WillA97/STM32_Play_Board/README.md

# STM32_Play_Board
 schematic of the microcontroller pcb files
