WillA97/STM32_Play_Board/STM32_Play_Board.kicad_pcb

## KiCad design STM32_Play_Board.kicad_pcb (2024-08-05)

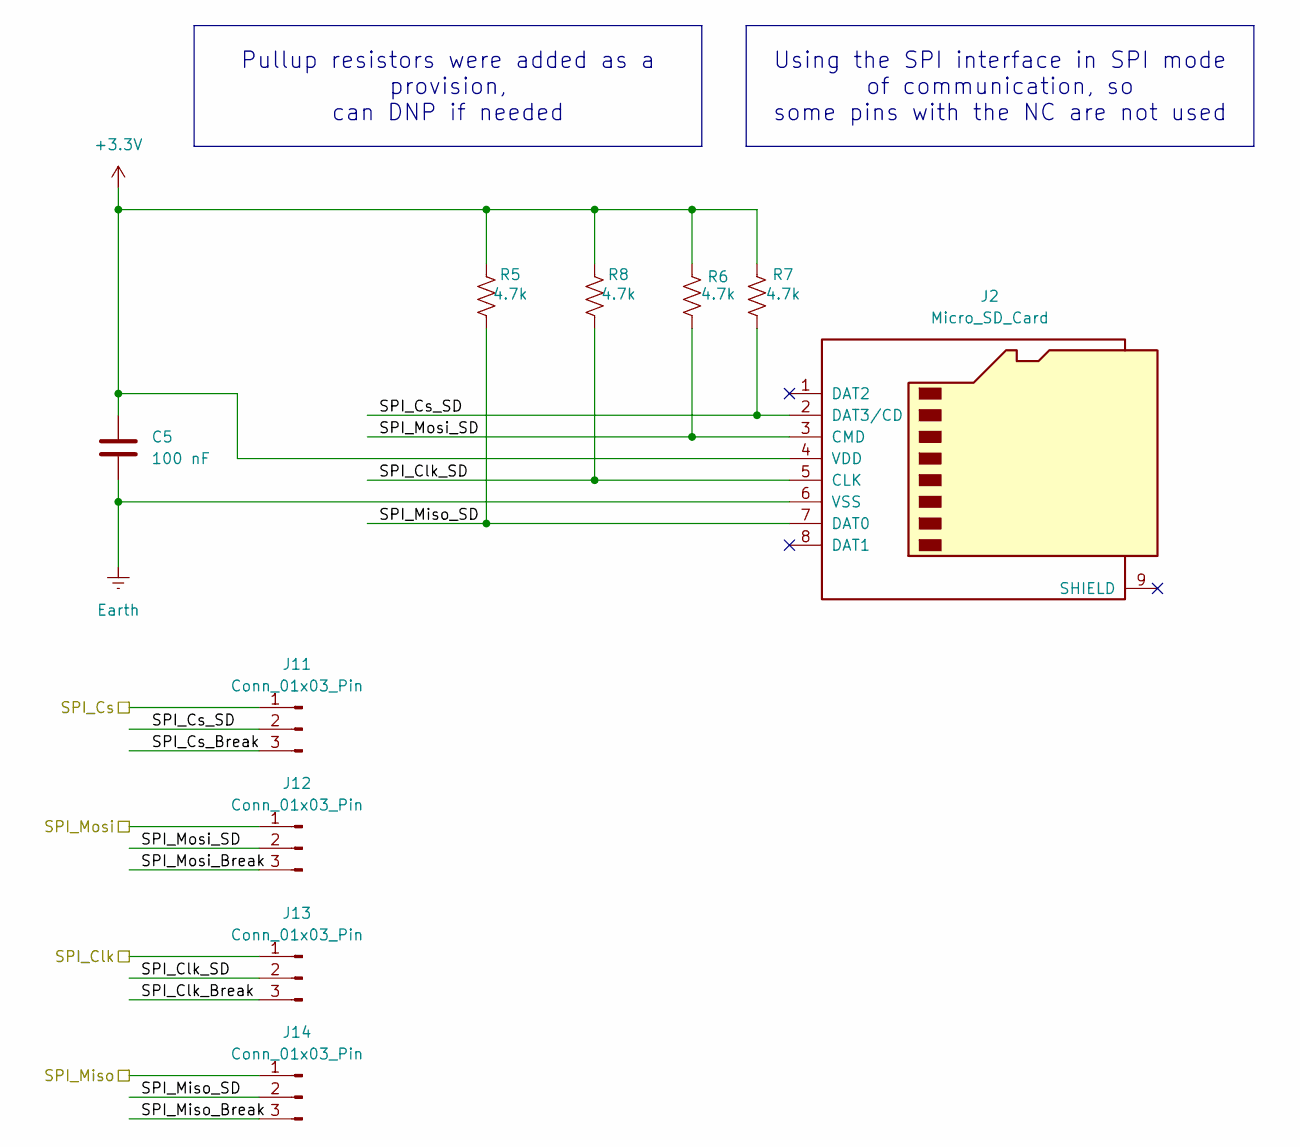
[picture p1: schematic SD_CARD.kicad_sch]

Parts:
C5: 100 nF; C_0805_2012Metric
J2: Micro_SD_Card; microSD_HC_Molex_104031-0811
J11, J12, J13, J14: Conn_01x03_Pin; PinHeader_1x03_P2.54mm_Vertical
R5, R6, R7, R8: 4.7k; R_0805_2012Metric

Connections:
+3.3V: C5.1, J2.4 (VDD), R5.1, R6.1, R7.1, R8.1; also elsewhere on the board
/Micrcontroller STM32C0/SPI_Clk: J13.1; also elsewhere on the board
/Micrcontroller STM32C0/SPI_Cs: J11.1; also elsewhere on the board
/Micrcontroller STM32C0/SPI_Miso: J14.1; also elsewhere on the board
/Micrcontroller STM32C0/SPI_Mosi: J12.1; also elsewhere on the board
/SD_CARD/SPI_Clk_Break: J13.3
/SD_CARD/SPI_Clk_SD: J2.5 (CLK), J13.2, R8.2
/SD_CARD/SPI_Cs_Break: J11.3
/SD_CARD/SPI_Cs_SD: J2.2 (DAT3/CD), J11.2, R7.2
/SD_CARD/SPI_Miso_Break: J14.3
/SD_CARD/SPI_Miso_SD: J2.7 (DAT0), J14.2, R5.2
/SD_CARD/SPI_Mosi_Break: J12.3
/SD_CARD/SPI_Mosi_SD: J2.3 (CMD), J12.2, R6.2
Earth: C5.2, J2.6 (VSS); also elsewhere on the board

Notes on the sheet:
Using the SPI interface in SPI mode of communication, so some pins with the NC are not used
Pullup resistors were added as a provision, can DNP if needed

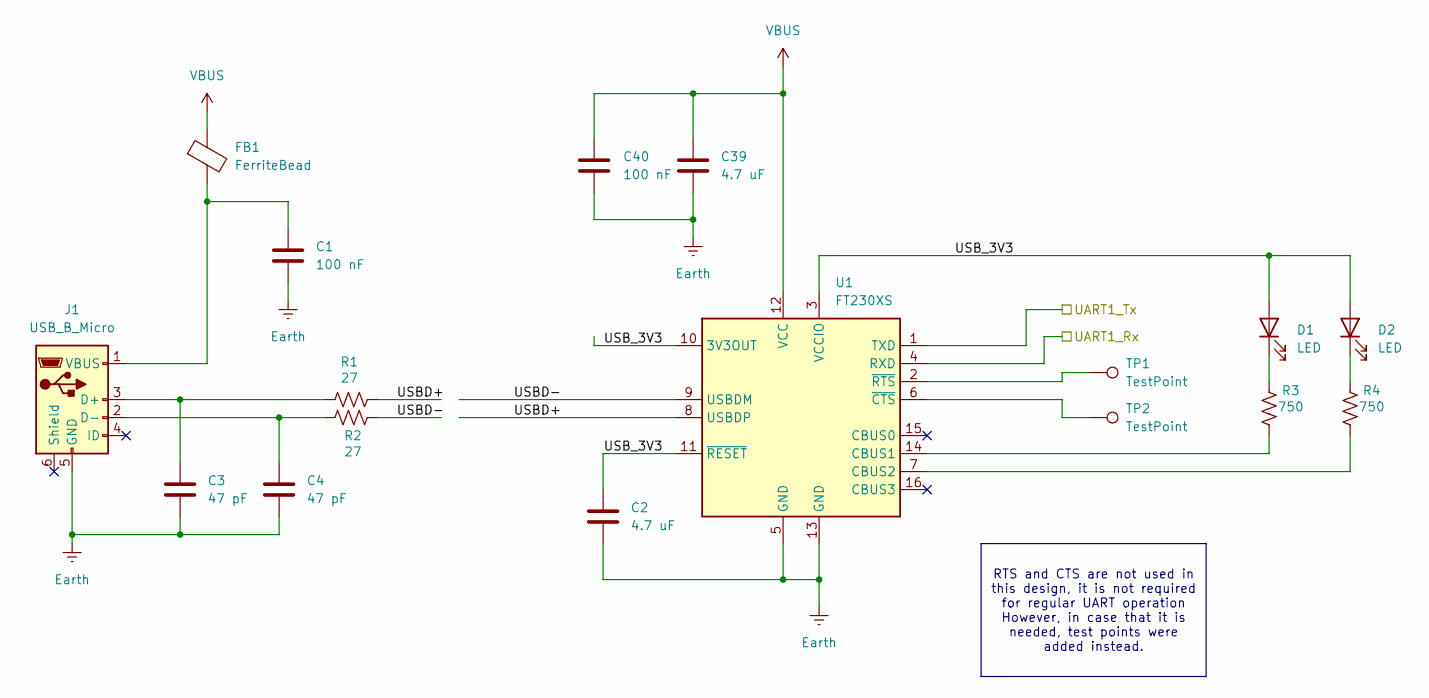
[picture p2: schematic USB_to_UART.kicad_sch]

Parts:
C1, C40: 100 nF; C_0805_2012Metric
C2, C39: 4.7 uF; C_0805_2012Metric
C3, C4: 47 pF; C_0805_2012Metric
D1, D2: LED; LED_0805_2012Metric
FB1: FerriteBead; L_0805_2012Metric
J1: USB_B_Micro; USB_Micro-B_Wuerth_629105150521
R1, R2: 27; R_0805_2012Metric
R3, R4: 750; R_0805_2012Metric
TP1, TP2: TestPoint; TestPoint_Pad_2.0x2.0mm
U1: FT230XS; SSOP-16_3.9x4.9mm_P0.635mm

Connections:
/Micrcontroller STM32C0/UART1_Rx: U1.4 (RXD); also elsewhere on the board
/Micrcontroller STM32C0/UART1_Tx: U1.1 (TXD); also elsewhere on the board
/USB to UART/USBD+: R1.2, U1.8 (USBDP)
/USB to UART/USBD-: R2.2, U1.9 (USBDM)
/USB to UART/USB_3V3: C2.1, D1.2 (A), D2.2 (A), U1.3 (VCCIO), U1.10 (3V3OUT), U1.11 (~RESET)
Earth: C1.2, C2.2, C3.2, C4.2, C39.2, C40.2, J1.5 (GND), U1.5 (GND), U1.13 (GND); also elsewhere on the board
unnamed: D1.1 (K), R3.1
unnamed: D2.1 (K), R4.1
unnamed: C3.1, J1.3 (D+), R1.1
unnamed: C4.1, J1.2 (D-), R2.1
unnamed: C1.1, FB1.2, J1.1 (VBUS)
unnamed: R3.2, U1.14 (CBUS1)
unnamed: R4.2, U1.7 (CBUS2)
unnamed: TP2.1, U1.6 (~CTS)
unnamed: TP1.1, U1.2 (~RTS)
VBUS: C39.1, C40.1, FB1.1, U1.12 (VCC); also elsewhere on the board

Notes on the sheet:
RTS and CTS are not used in this design, it is not required for regular UART operation However, in case that it is needed, test points were added instead.

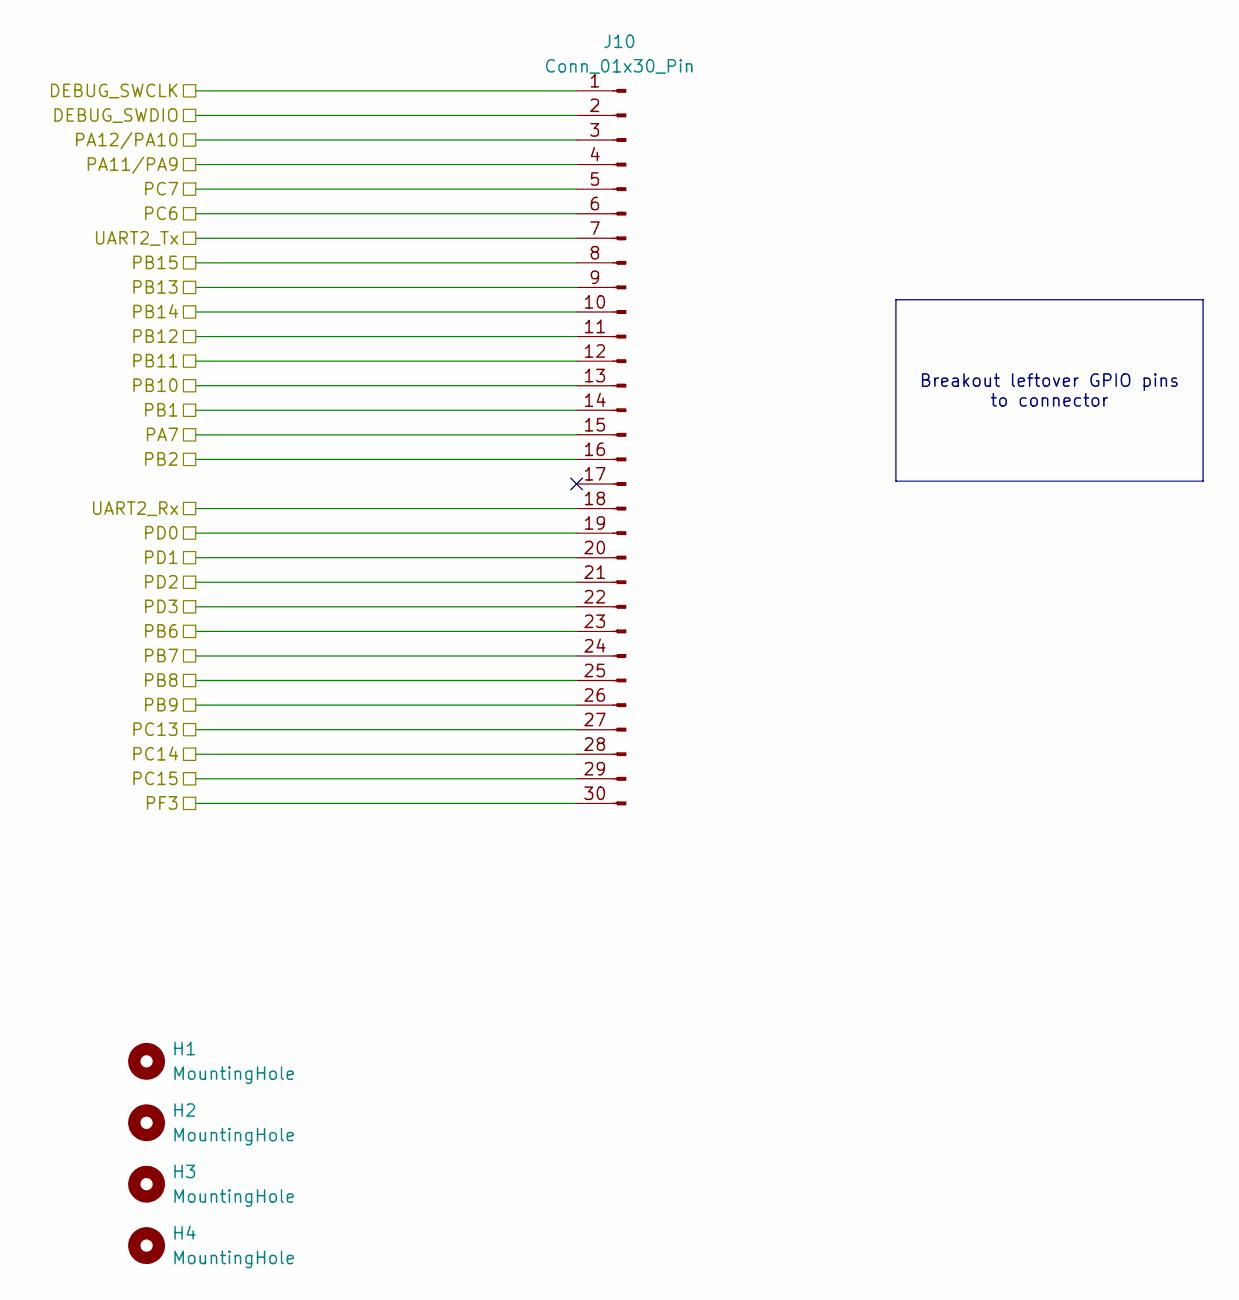
[picture p3: schematic Connectors.kicad_sch]

Parts:
H1, H2, H3, H4: MountingHole; MountingHole_3.2mm_M3
J10: Conn_01x30_Pin; PinHeader_1x30_P2.54mm_Vertical

Connections:
/Connectors/DEBUG_SWCLK: J10.1; also elsewhere on the board
/Connectors/DEBUG_SWDIO: J10.2; also elsewhere on the board
/Connectors/PA7: J10.15; also elsewhere on the board
/Connectors/PA11/PA9: J10.4; also elsewhere on the board
/Connectors/PA12/PA10: J10.3; also elsewhere on the board
/Connectors/PB1: J10.14; also elsewhere on the board
/Connectors/PB2: J10.16; also elsewhere on the board
/Connectors/PB6: J10.23; also elsewhere on the board
/Connectors/PB7: J10.24; also elsewhere on the board
/Connectors/PB8: J10.25; also elsewhere on the board
/Connectors/PB9: J10.26; also elsewhere on the board
/Connectors/PB10: J10.13; also elsewhere on the board
/Connectors/PB11: J10.12; also elsewhere on the board
/Connectors/PB12: J10.11; also elsewhere on the board
/Connectors/PB13: J10.9; also elsewhere on the board
/Connectors/PB14: J10.10; also elsewhere on the board
/Connectors/PB15: J10.8; also elsewhere on the board
/Connectors/PC6: J10.6; also elsewhere on the board
/Connectors/PC7: J10.5; also elsewhere on the board
/Connectors/PC13: J10.27; also elsewhere on the board
/Connectors/PC14: J10.28; also elsewhere on the board
/Connectors/PC15: J10.29; also elsewhere on the board
/Connectors/PD0: J10.19; also elsewhere on the board
/Connectors/PD1: J10.20; also elsewhere on the board
/Connectors/PD2: J10.21; also elsewhere on the board
/Connectors/PD3: J10.22; also elsewhere on the board
/Connectors/PF3: J10.30; also elsewhere on the board
/Micrcontroller STM32C0/UART2_Rx: J10.18; also elsewhere on the board
/Micrcontroller STM32C0/UART2_Tx: J10.7; also elsewhere on the board

Notes on the sheet:
Breakout leftover GPIO pins to connector

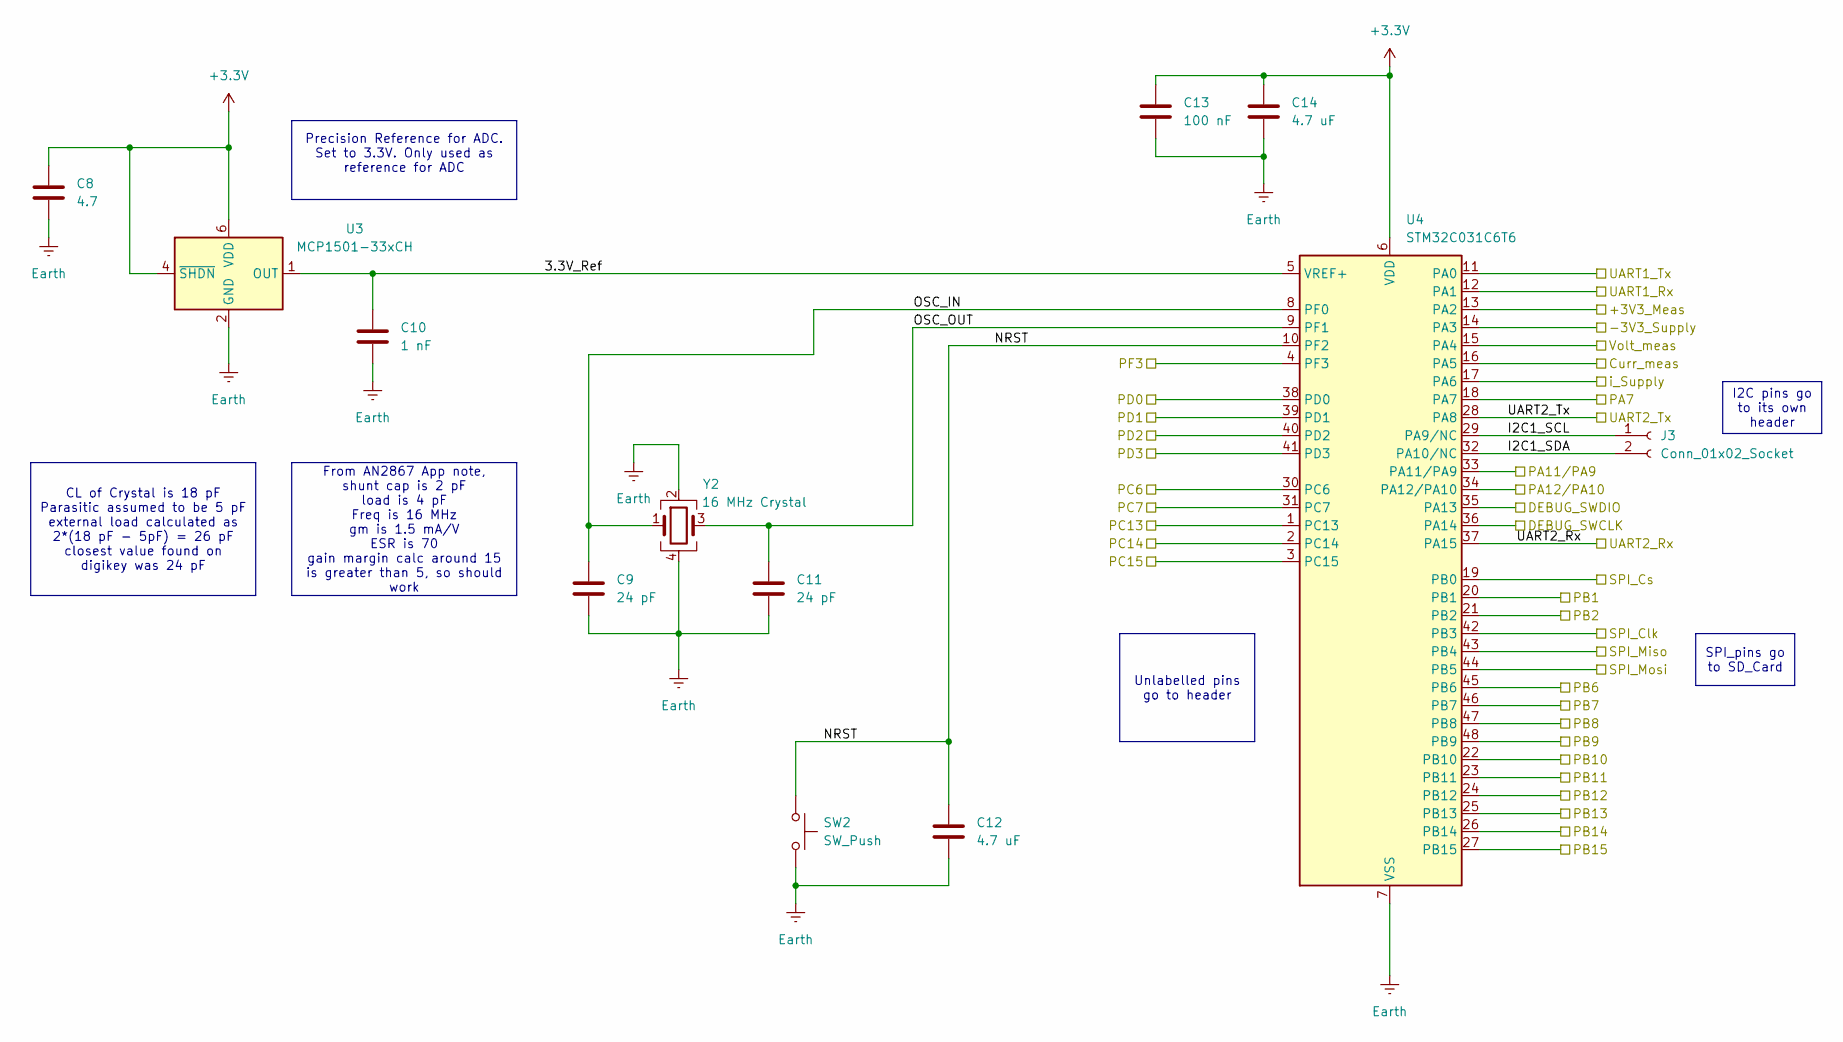
[picture p4: schematic Microntroller.kicad_sch]

Parts:
C8: 4.7; C_0805_2012Metric
C9, C11: 24 pF; C_0805_2012Metric
C10: 1 nF; C_0805_2012Metric
C12, C14: 4.7 uF; C_0805_2012Metric
C13: 100 nF; C_0805_2012Metric
J3: Conn_01x02_Socket; Molex_KK-254_AE-6410-02A_1x02_P2.54mm_Vertical
SW2: SW_Push; SW_PUSH_6mm
U3: MCP1501-33xCH; SOT-23-6
U4: STM32C031C6T6; LQFP-48_7x7mm_P0.5mm
Y2: 16 MHz Crystal; Oscillator_SMD_Abracon_ASE-4Pin_3.2x2.5mm_HandSoldering

Connections:
+3.3V: C8.1, C13.1, C14.1, U3.4 (~SHDN), U3.6 (VDD), U4.6 (VDD); also elsewhere on the board
/Connectors/DEBUG_SWCLK: U4.36 (PA14); also elsewhere on the board
/Connectors/DEBUG_SWDIO: U4.35 (PA13); also elsewhere on the board
/Connectors/PA7: U4.18 (PA7); also elsewhere on the board
/Connectors/PA11/PA9: U4.33 (PA11/PA9); also elsewhere on the board
/Connectors/PA12/PA10: U4.34 (PA12/PA10); also elsewhere on the board
/Connectors/PB1: U4.20 (PB1); also elsewhere on the board
/Connectors/PB2: U4.21 (PB2); also elsewhere on the board
/Connectors/PB6: U4.45 (PB6); also elsewhere on the board
/Connectors/PB7: U4.46 (PB7); also elsewhere on the board
/Connectors/PB8: U4.47 (PB8); also elsewhere on the board
/Connectors/PB9: U4.48 (PB9); also elsewhere on the board
/Connectors/PB10: U4.22 (PB10); also elsewhere on the board
/Connectors/PB11: U4.23 (PB11); also elsewhere on the board
/Connectors/PB12: U4.24 (PB12); also elsewhere on the board
/Connectors/PB13: U4.26 (PB14); also elsewhere on the board
/Connectors/PB14: U4.25 (PB13); also elsewhere on the board
/Connectors/PB15: U4.27 (PB15); also elsewhere on the board
/Connectors/PC6: U4.30 (PC6); also elsewhere on the board
/Connectors/PC7: U4.31 (PC7); also elsewhere on the board
/Connectors/PC13: U4.1 (PC13); also elsewhere on the board
/Connectors/PC14: U4.2 (PC14); also elsewhere on the board
/Connectors/PC15: U4.3 (PC15); also elsewhere on the board
/Connectors/PD0: U4.38 (PD0); also elsewhere on the board
/Connectors/PD1: U4.39 (PD1); also elsewhere on the board
/Connectors/PD2: U4.40 (PD2); also elsewhere on the board
/Connectors/PD3: U4.41 (PD3); also elsewhere on the board
/Connectors/PF3: U4.4 (PF3); also elsewhere on the board
/Micrcontroller STM32C0/3.3V_Ref: C10.1, U3.1 (OUT), U4.5 (VREF+)
/Micrcontroller STM32C0/+3V3_Meas: U4.13 (PA2); also elsewhere on the board
/Micrcontroller STM32C0/-3V3_Supply: U4.14 (PA3); also elsewhere on the board
/Micrcontroller STM32C0/Curr_meas: U4.16 (PA5); also elsewhere on the board
/Micrcontroller STM32C0/I2C1_SCL: J3.1, U4.29 (PA9/NC)
/Micrcontroller STM32C0/I2C1_SDA: J3.2, U4.32 (PA10/NC)
/Micrcontroller STM32C0/NRST: C12.1, SW2.1, U4.10 (PF2)
/Micrcontroller STM32C0/OSC_IN: C9.1, U4.8 (PF0), Y2.1
/Micrcontroller STM32C0/OSC_OUT: C11.1, U4.9 (PF1), Y2.3
/Micrcontroller STM32C0/SPI_Clk: U4.42 (PB3); also elsewhere on the board
/Micrcontroller STM32C0/SPI_Cs: U4.19 (PB0); also elsewhere on the board
/Micrcontroller STM32C0/SPI_Miso: U4.43 (PB4); also elsewhere on the board
/Micrcontroller STM32C0/SPI_Mosi: U4.44 (PB5); also elsewhere on the board
/Micrcontroller STM32C0/UART1_Rx: U4.12 (PA1); also elsewhere on the board
/Micrcontroller STM32C0/UART1_Tx: U4.11 (PA0); also elsewhere on the board
/Micrcontroller STM32C0/UART2_Rx: U4.37 (PA15); also elsewhere on the board
/Micrcontroller STM32C0/UART2_Tx: U4.28 (PA8); also elsewhere on the board
/Micrcontroller STM32C0/Volt_meas: U4.15 (PA4); also elsewhere on the board
/Micrcontroller STM32C0/i_Supply: U4.17 (PA6); also elsewhere on the board
Earth: C8.2, C9.2, C10.2, C11.2, C12.2, C13.2, C14.2, SW2.2, U3.2 (GND), U3.3 (GND), U3.5 (GND), U4.7 (VSS), Y2.2, Y2.4; also elsewhere on the board

Notes on the sheet:
Precision Reference for ADC. Set to 3.3V. Only used as reference for ADC
Unlabelled pins go to header
I2C pins go to its own header
CL of Crystal is 18 pF Parasitic assumed to be 5 pF external load calculated as 2*(18 pF - 5pF) = 26 pF closest value found on digikey was 24 pF
From AN2867 App note, shunt cap is 2 pF load is 4 pF Freq is 16 MHz gm is 1.5 mA/V ESR is 70 gain margin calc around 15 is greater than 5, so should work
SPI_pins go to SD_Card

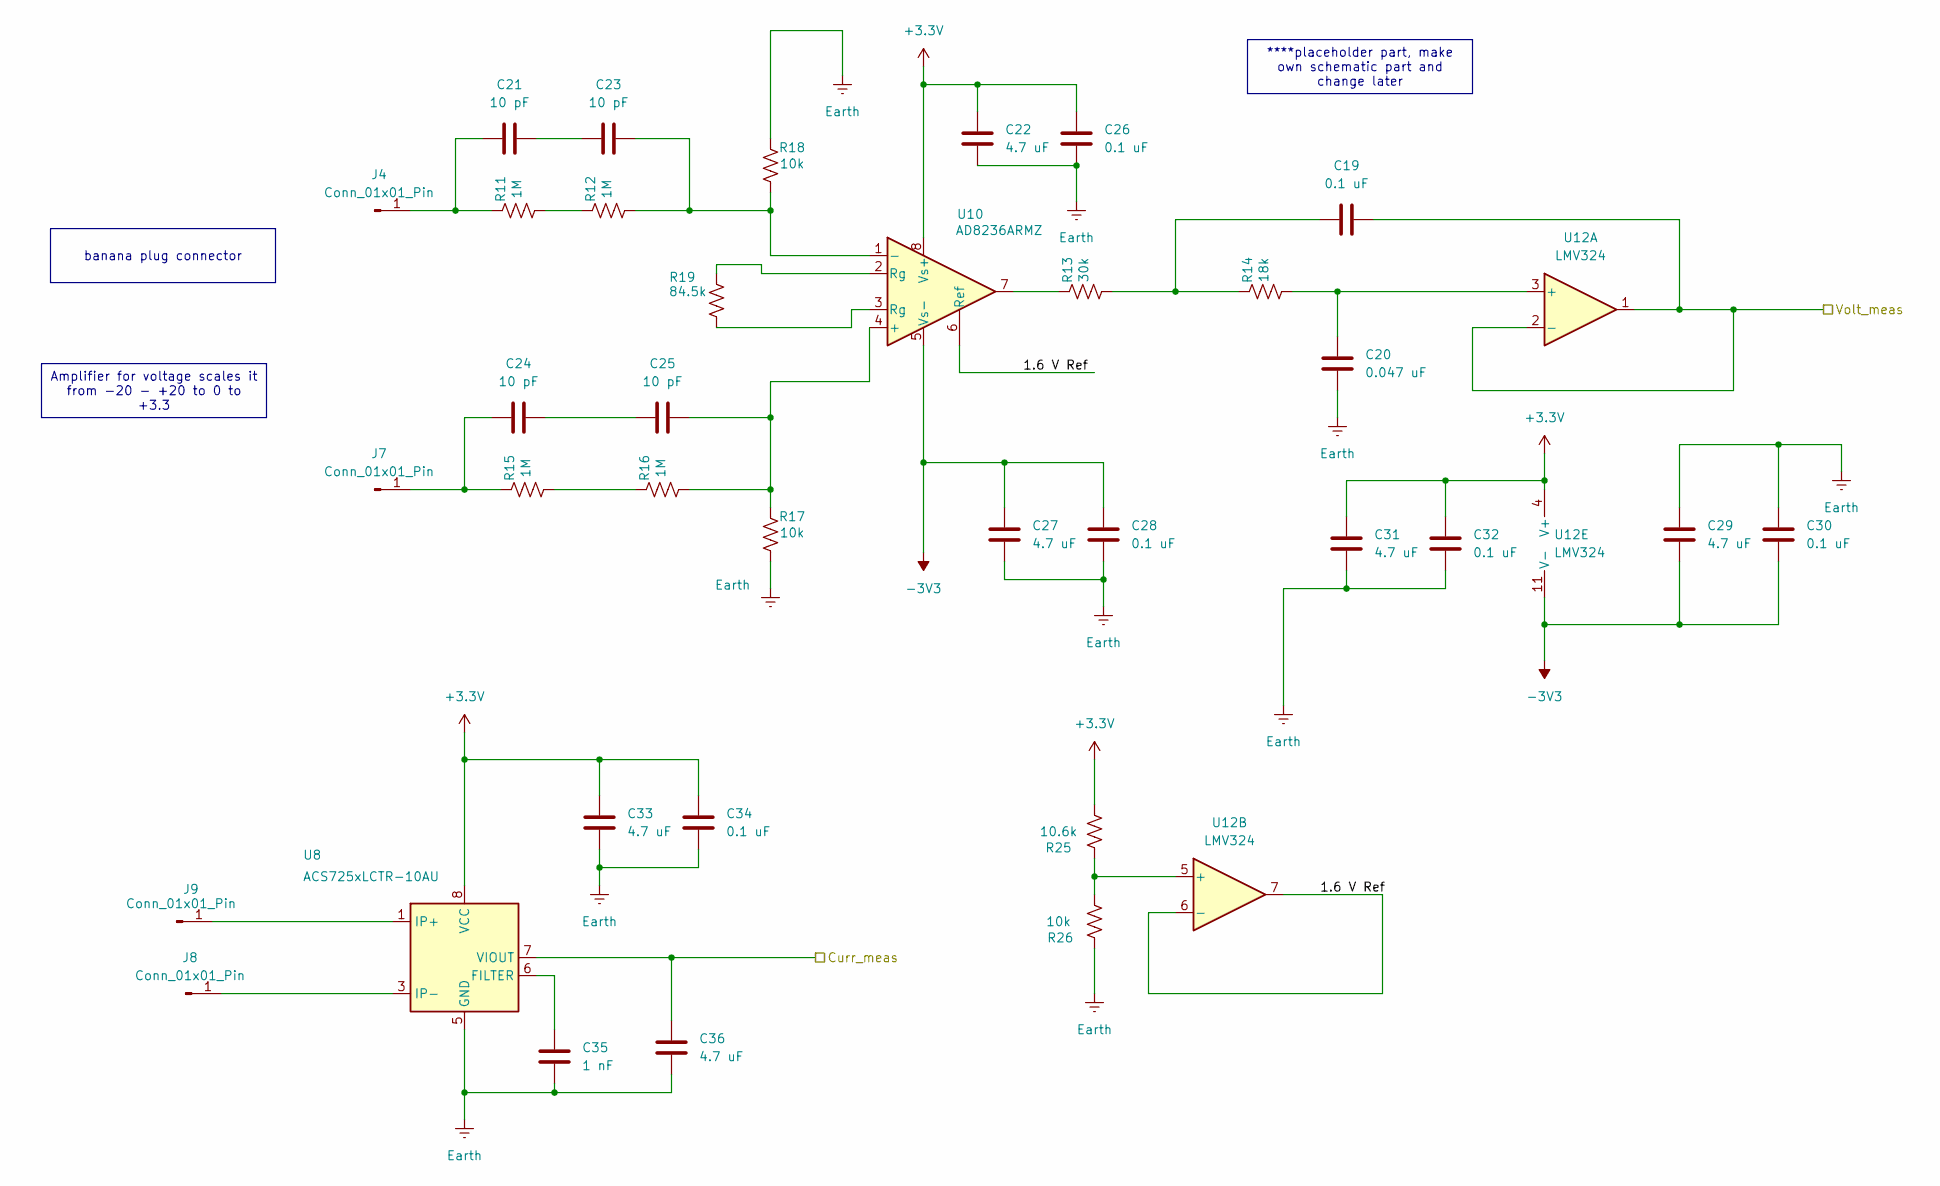
[picture p5: schematic Voltage_and_Current_Measurement.kicad_sch]

Parts:
C19, C26, C28, C30, C32, C34: 0.1 uF; C_0805_2012Metric
C20: 0.047 uF; C_0805_2012Metric
C21, C23, C24, C25: 10 pF; C_0805_2012Metric
C22, C27, C29, C31, C33, C36: 4.7 uF; C_0805_2012Metric
C35: 1 nF; C_0805_2012Metric
J4, J7, J8, J9: Conn_01x01_Pin; Banana_Jack_1Pin
R11, R12, R15, R16: 1M; R_0805_2012Metric
R13: 30k; R_0805_2012Metric
R14: 18k; R_0805_2012Metric
R17, R18, R26: 10k; R_0805_2012Metric
R19: 84.5k; R_0805_2012Metric
R25: 10.6k; R_0805_2012Metric
U8: ACS725xLCTR-10AU; SOIC-8_3.9x4.9mm_P1.27mm
U10: AD8236ARMZ; MSOP-8_3x3mm_P0.65mm
U12: LMV324; SOIC-14_3.9x8.7mm_P1.27mm_STM32_Play

Connections:
+3.3V: C22.2, C26.2, C31.2, C32.2, C33.2, C34.2, R25.2, U8.8 (VCC), U10.8 (Vs+), U12.4 (V+); also elsewhere on the board
-3V3: C27.2, C28.2, C29.1, C30.1, U10.5 (Vs-), U12.11 (V-); also elsewhere on the board
/Micrcontroller STM32C0/Curr_meas: C36.2, U8.7 (VIOUT); also elsewhere on the board
/Micrcontroller STM32C0/Volt_meas: C19.2, U12.1, U12.2 (-); also elsewhere on the board
/Voltage and Current Measurement/1.6 V Ref: U10.6 (Ref), U12.6 (-), U12.7
Earth: C20.1, C22.1, C26.1, C27.1, C28.1, C29.2, C30.2, C31.1, C32.1, C33.1, C34.1, C35.1, C36.1, R17.2, R18.1, R26.1, U8.5 (GND); also elsewhere on the board
unnamed: C19.1, R13.2, R14.1
unnamed: C21.2, C23.1
unnamed: C24.2, C25.1
unnamed: C21.1, J4.1, R11.1
unnamed: C24.1, J7.1, R15.1
unnamed: J8.1, U8.3 (IP-), U8.4 (IP-)
unnamed: J9.1, U8.1 (IP+), U8.2 (IP+)
unnamed: R11.2, R12.1
unnamed: R13.1, U10.7
unnamed: R15.2, R16.1
unnamed: R19.1, U10.2 (Rg)
unnamed: R19.2, U10.3 (Rg)
unnamed: C35.2, U8.6 (FILTER)
unnamed: C25.2, R16.2, R17.1, U10.4 (+)
unnamed: C23.2, R12.2, R18.2, U10.1 (-)
unnamed: C20.2, R14.2, U12.3 (+)
unnamed: R25.1, R26.2, U12.5 (+)

Notes on the sheet:
Amplifier for voltage scales it from -20 - +20 to 0 to +3.3
****placeholder part, make own schematic part and change later
banana plug connector

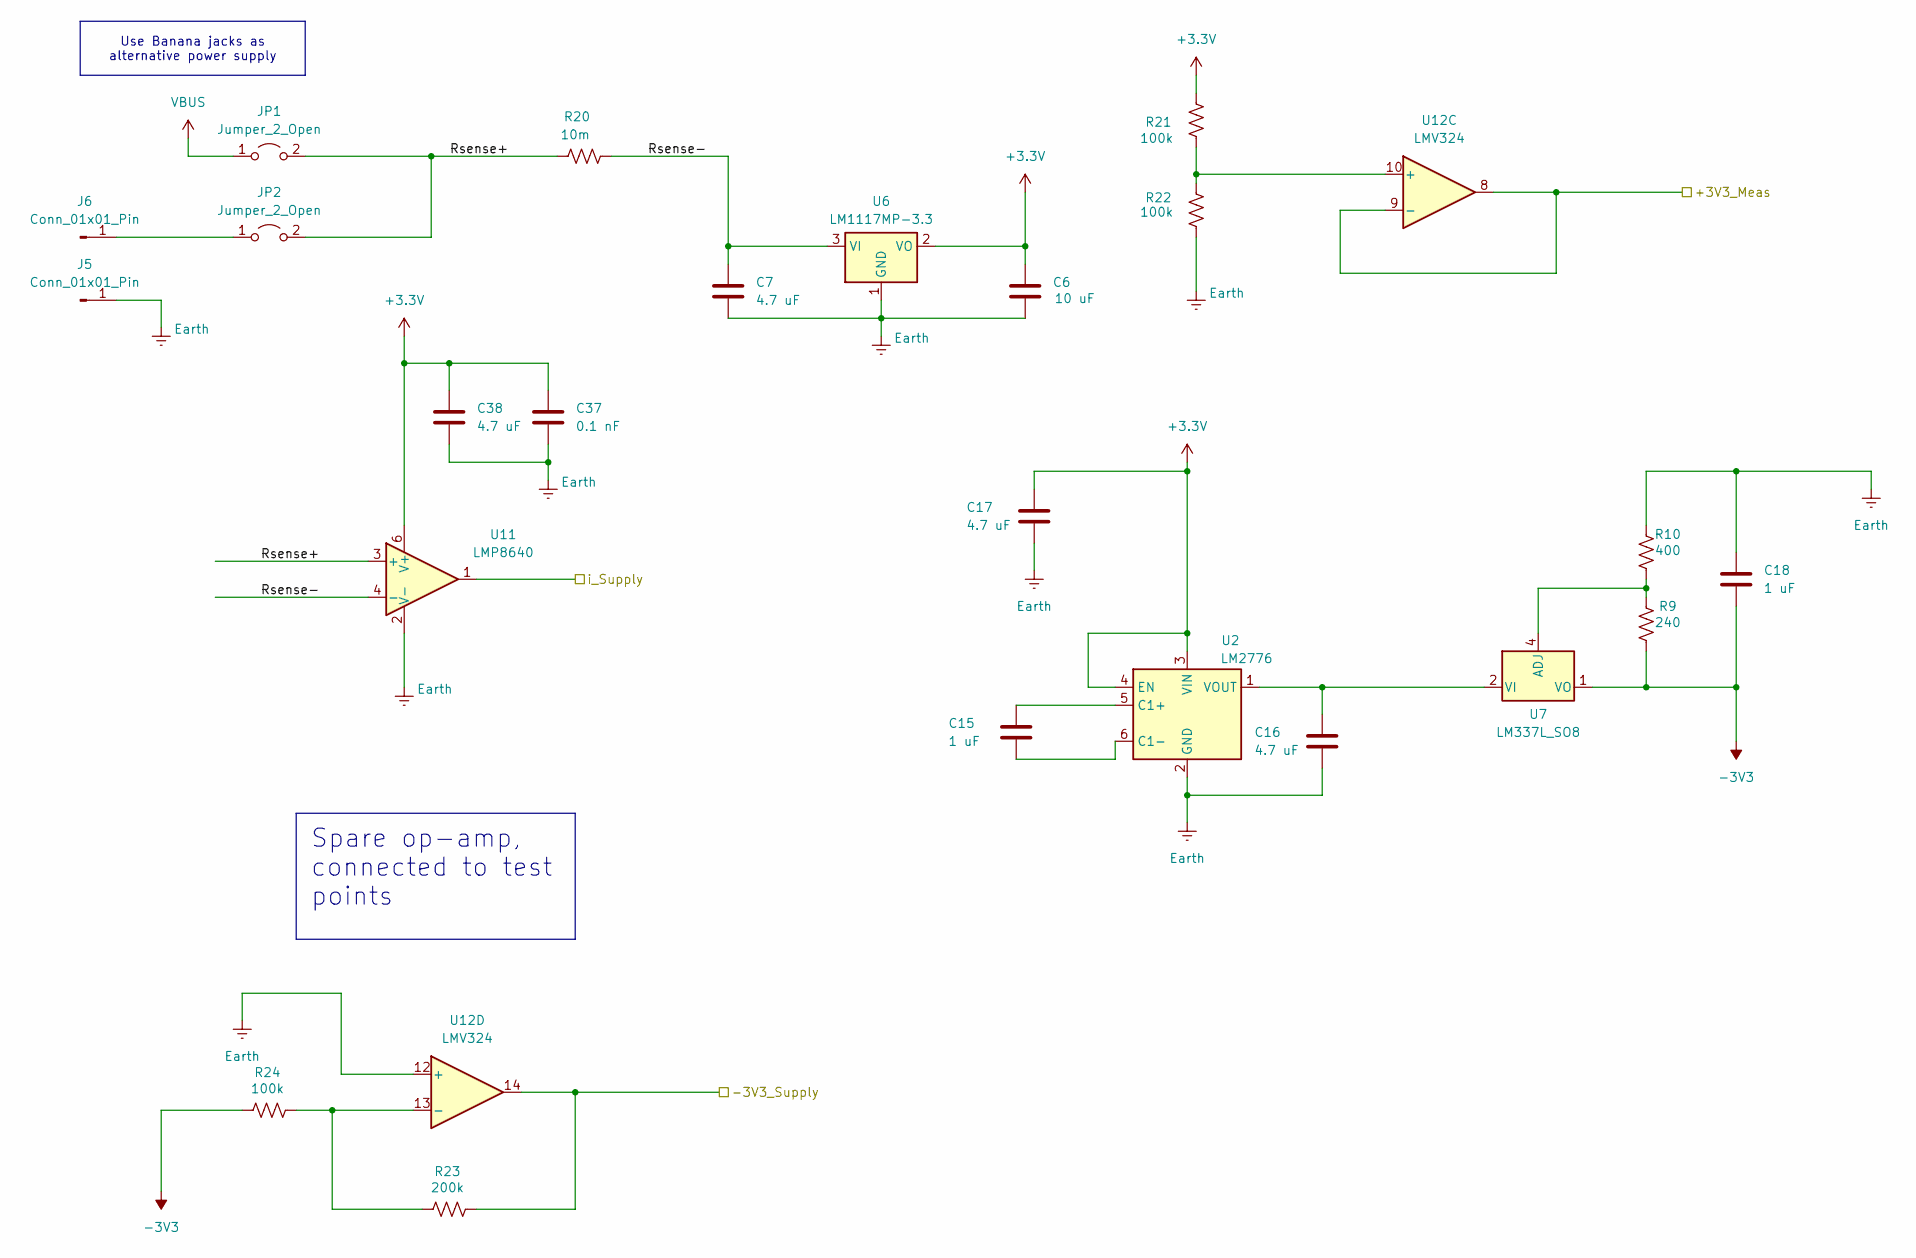
[picture p6: schematic Power.kicad_sch]

Parts:
C6: 10 uF; C_0805_2012Metric
C7, C16, C17, C38: 4.7 uF; C_0805_2012Metric
C15, C18: 1 uF; C_0805_2012Metric
C37: 0.1 nF; C_0805_2012Metric
J5: Conn_01x01_Pin; TestPoint_THTPad_D1.5mm_Drill0.7mm
J6: Conn_01x01_Pin; TestPoint_THTPad_1.5x1.5mm_Drill0.7mm
JP1, JP2: Jumper_2_Open; PinHeader_1x02_P2.54mm_Vertical
R9: 240; R_0805_2012Metric
R10: 400; R_0805_2012Metric
R20: 10m; R_0805_2012Metric
R21, R22, R24: 100k; R_0805_2012Metric
R23: 200k; R_0805_2012Metric
U2: LM2776; SOT-23-6
U6: LM1117MP-3.3; SOT-223-3_TabPin2
U7: LM337L_SO8; SOIC-8_3.9x4.9mm_P1.27mm
U11: LMP8640; SOT-23-6
U12: LMV324; SOIC-14_3.9x8.7mm_P1.27mm_STM32_Play

Connections:
+3.3V: C6.1, C17.1, C37.1, C38.1, R21.2, U2.3 (VIN), U2.4 (EN), U6.2 (VO), U11.6 (V+); also elsewhere on the board
-3V3: C18.2, R9.2, R24.1, U7.1 (VO); also elsewhere on the board
/Micrcontroller STM32C0/+3V3_Meas: U12.8, U12.9 (-); also elsewhere on the board
/Micrcontroller STM32C0/-3V3_Supply: R23.2, U12.14; also elsewhere on the board
/Micrcontroller STM32C0/i_Supply: U11.1; also elsewhere on the board
/Power/Rsense+: JP1.2 (B), JP2.2 (B), R20.1, U11.3 (+)
/Power/Rsense-: C7.1, R20.2, U6.3 (VI), U11.4 (-)
Earth: C6.2, C7.2, C16.2, C17.2, C18.1, C37.2, C38.2, J5.1, R10.1, R22.1, U2.2 (GND), U6.1 (GND), U11.2 (V-), U12.12 (+); also elsewhere on the board
unnamed: J6.1, JP2.1 (A)
unnamed: C15.1, U2.5 (C1+)
unnamed: C15.2, U2.6 (C1-)
unnamed: C16.1, U2.1 (VOUT), U7.2 (VI), U7.3 (VI), U7.6 (VI), U7.7 (VI)
unnamed: R9.1, R10.2, U7.4 (ADJ)
unnamed: R21.1, R22.2, U12.10 (+)
unnamed: R23.1, R24.2, U12.13 (-)
VBUS: JP1.1 (A); also elsewhere on the board

Notes on the sheet:
Spare op-amp, connected to test points
Use Banana jacks as alternative power supply

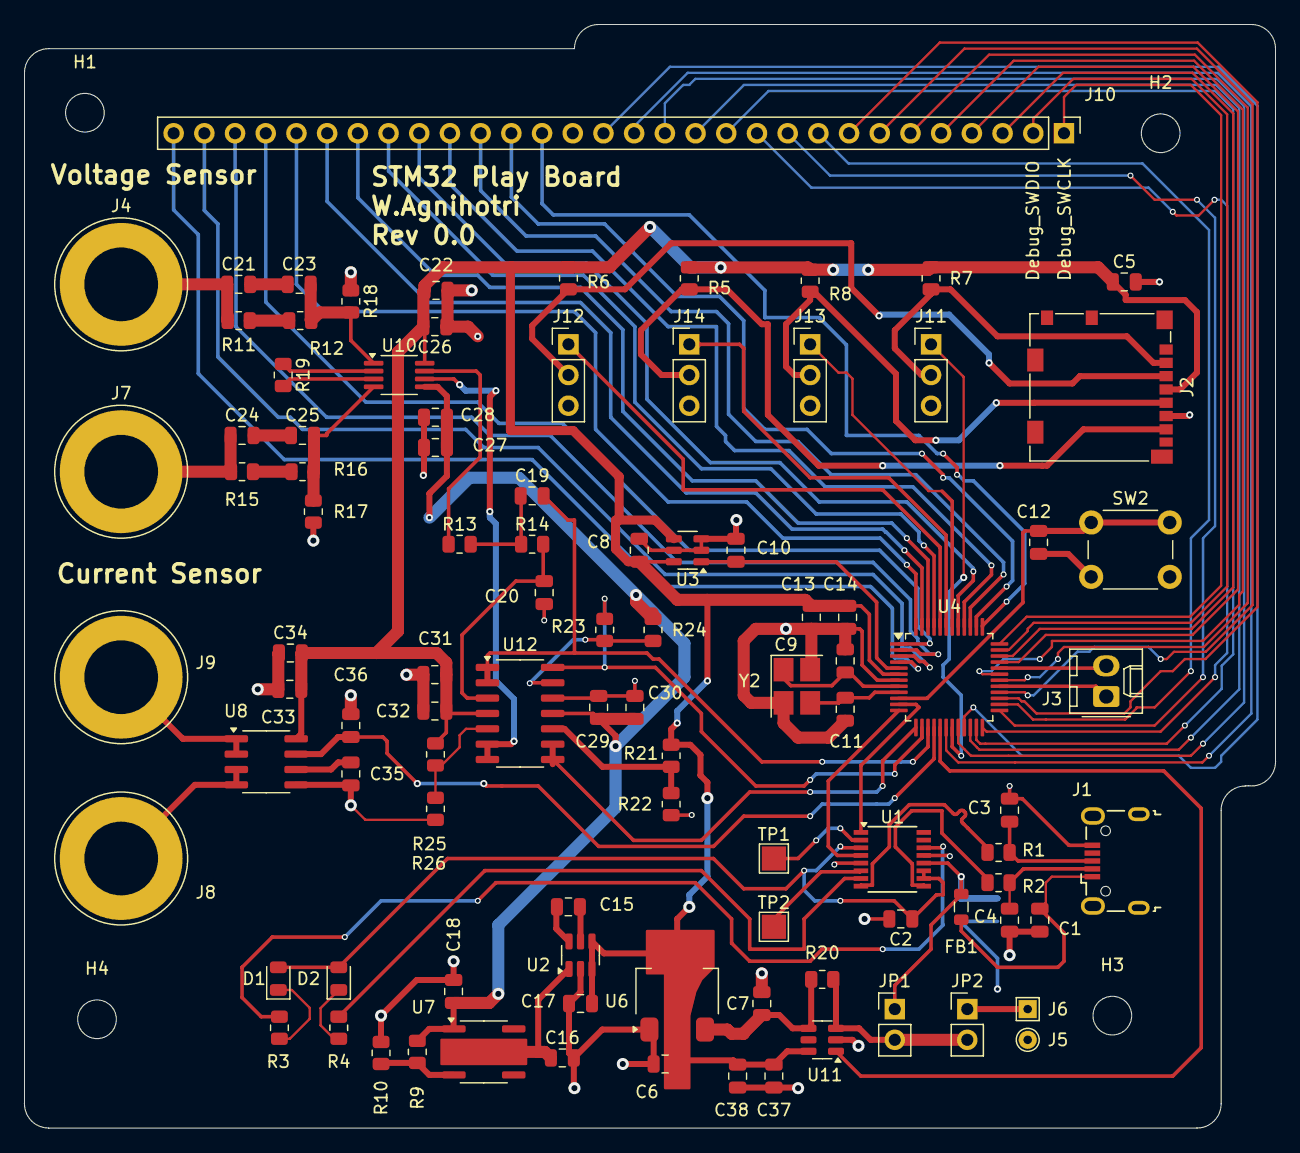
[picture p7: board STM32_Play_Board.kicad_pcb from above]

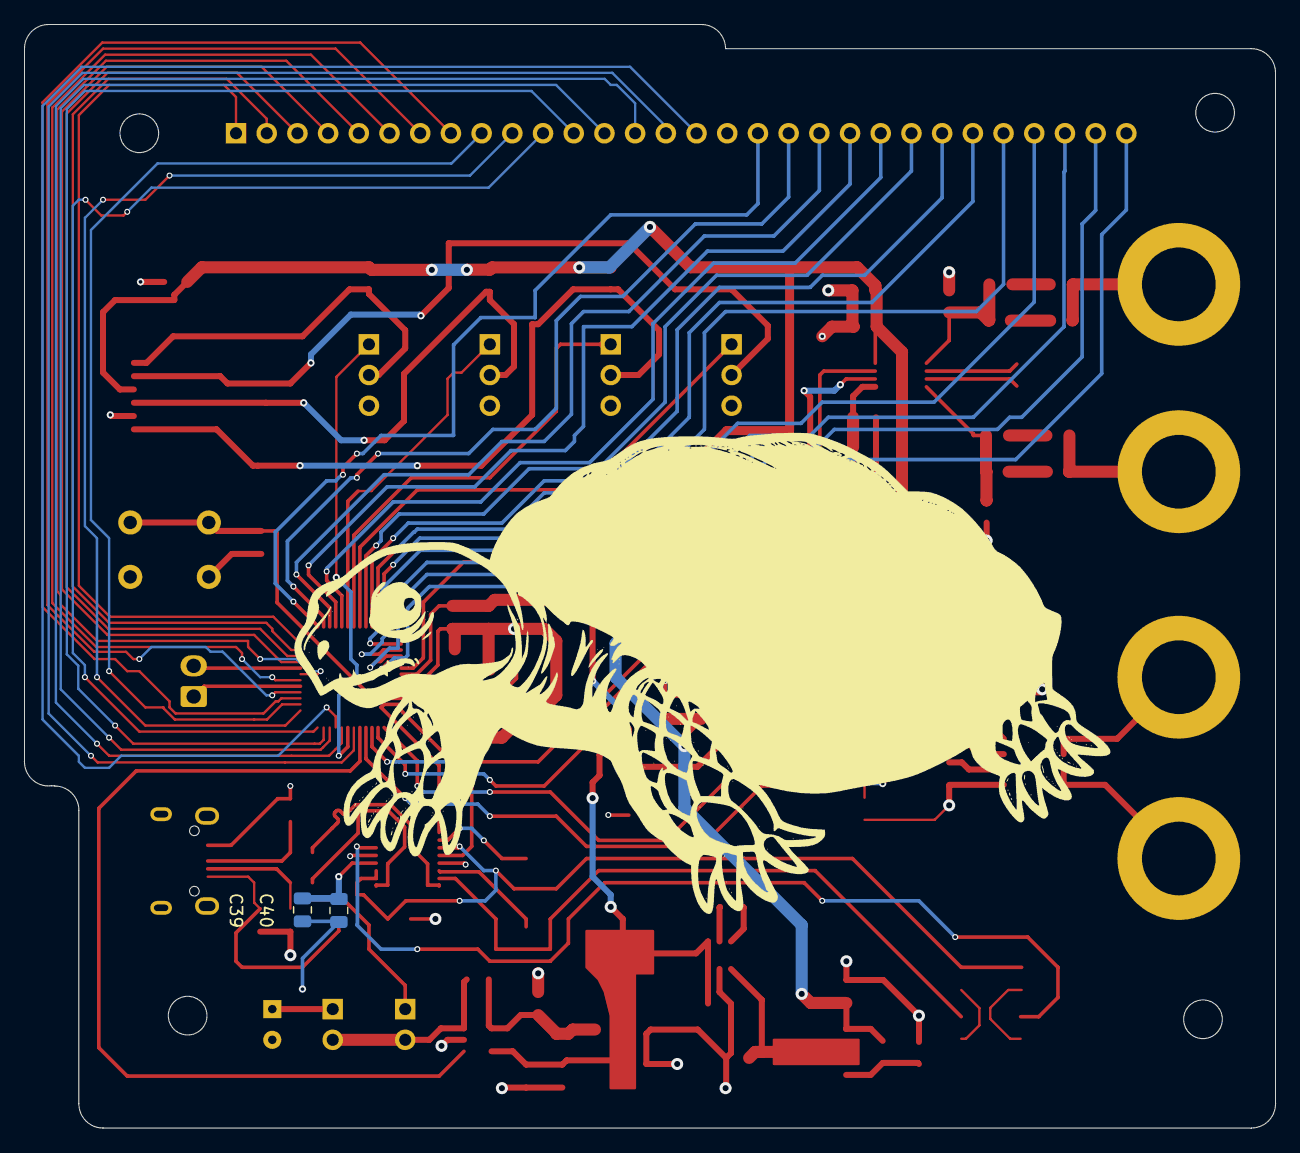
[picture p8: board STM32_Play_Board.kicad_pcb from below]

Board: 4 copper layers, 103.5 x 91.3 mm, 103 parts (2 on the bottom side), 93 nets.
