WillA97/STM32_Play_Board/STM32_PlayBoard_STM_Cube/Core/Src/main.c

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
/* Includes ------------------------------------------------------------------*/
#include "main.h"
#include "adc.h"
#include "dma.h"
#include "i2c.h"
#include "spi.h"
#include "tim.h"
#include "usart.h"
#include "gpio.h"


/* USER CODE BEGIN PV */
uint32_t val = 2456;
uint32_t* adc_val = &val;

/* USER CODE END PV */

void SystemClock_Config(void);
/* USER CODE BEGIN 0 */
uint8_t data[] = "The value of Channel 2 ADC is";
uint8_t data2[] = "\n\r";
uint8_t rx_data[1] = "0123";

/* USER CODE END 0 */

/**
  * @brief  The application entry point.
  * @retval int
  */
int main(void)
{

  /* USER CODE BEGIN 1 */
//	int32_t Ch1_duty = 5000;
  /* USER CODE END 1 */

  /* MCU Configuration--------------------------------------------------------*/

  /* Reset of all peripherals, Initializes the Flash interface and the Systick. */
  HAL_Init();

  /* Configure the system clock */
  SystemClock_Config();

  /* Initialize all configured peripherals */
  MX_GPIO_Init();
  MX_DMA_Init();
  MX_I2C1_Init();
  MX_SPI1_Init();
  MX_USART1_UART_Init();
  MX_USART2_UART_Init();
  MX_ADC1_Init();
  MX_TIM3_Init();
  /* USER CODE BEGIN 2 */
  HAL_TIM_PWM_Start(&htim3, TIM_CHANNEL_1);
  HAL_UART_Receive_IT(&huart1,rx_data,4);
  /* USER CODE END 2 */

  /* Infinite loop */
  /* USER CODE BEGIN WHILE */
  while (1)
  {
	    HAL_ADC_Start(&hadc1); // start the adc
	    HAL_ADC_PollForConversion(&hadc1, HAL_MAX_DELAY); // poll for conversion

	    *adc_val = HAL_ADC_GetValue(&hadc1); // get the adc value
	    val = *adc_val;

	    HAL_ADC_Stop(&hadc1); // stop adc

	    val = 103;

	  //HAL_UART_Transmit(&huart1, data, sizeof (data), 10000);
	  HAL_UART_Transmit(&huart1,(uint8_t *) adc_val, 4, HAL_MAX_DELAY);
	 // HAL_UART_Transmit(&huart1, data2, 4, HAL_MAX_DELAY);

	  HAL_Delay (2000); // wait for 500ms

	//  HAL_GPIO_TogglePin(GPIOF, GPIO_PIN_3);
	//  TIM3 ->CCR1 = Ch1_duty;
	//  HAL_UART_Transmit(&huart1, data, 12, 1000);
	//  HAL_Delay(1000);
    /* USER CODE END WHILE */

    /* USER CODE BEGIN 3 */
  }
  /* USER CODE END 3 */
}

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
/* USER CODE BEGIN 4 */
/*
void HAL_UART_RxCpltCallback(UART_HandleTypeDef *huart)
{

	HAL_UART_Transmit(&huart1, rx_data, 4, 100);
	HAL_UART_Receive_IT(&huart1,rx_data,4);


}*/
/* USER CODE END 4 */
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
