WillA97/STM32_Play_Board/STM32_PlayBoard_STM_Cube/STM32Play_Board.ioc

Mcu.UserName=STM32C031C6Tx
PA0.Signal=USART1_TX
PA1.Signal=USART1_RX
PA10.Signal=I2C1_SDA
PA13.Signal=DEBUG_SWDIO
PA14-BOOT0.Signal=DEBUG_SWCLK
PA15.Signal=USART2_RX
PA2.Signal=ADC1_IN2
PA3.Signal=ADC1_IN3
PA4.Signal=ADC1_IN4
PA5.Signal=ADC1_IN5
PA6.Signal=ADC1_IN6
PA8.Signal=USART2_TX
PA9.Signal=I2C1_SCL
PB0.Signal=SPI1_NSS
PB3.Signal=SPI1_SCK
PB4.Signal=SPI1_MISO
PB5.Signal=SPI1_MOSI
PC6.Signal=S_TIM3_CH1
PF3.Signal=GPIO_Output
