WillA97/STM32_Play_Board/(commit log)

2024-04-07 added components and schematics
    [Microntroller.kicad_sch, Power.kicad_sch, SD_CARD.kicad_sch, STM32_Play_Board.kicad_sch, USB_to_UART.kicad_sch, untitled.kicad_sch]
2024-04-08 added power components
    [Power.kicad_sch, SD_CARD.kicad_sch, USB_to_UART.kicad_sch]
2024-04-14 added voltage measurement and current measurement
    [Power.kicad_sch, Voltage_and_Current_Measurement.kicad_sch]
2024-04-22 updated schematics added the stm cube project file
    [Microntroller.kicad_sch, Power.kicad_sch, Voltage_and_Current_Measurement.kicad_sch]
2024-05-02 changes to schematic and PCB
    [Connectors.kicad_sch, Microntroller.kicad_sch, Power.kicad_sch, SD_CARD.kicad_sch, STM32_Play_Board.kicad_pcb, STM32_Play_Board.kicad_sch, USB_to_UART.kicad_sch, Voltage_and_Current_Measurement.kicad_sch]
2024-05-13 changed schematics
    [Connectors.kicad_sch, Microntroller.kicad_sch, Power.kicad_sch, SD_CARD.kicad_sch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]
2024-05-20 changes to schematic
    [Power.kicad_sch]
2024-08-05 m,vm
    not sure what changes are made lol
    [STM32_Play_Board.kicad_pcb]
