WillA97/STM32_Play_Board/(notices)

Notices in the files:
STM32_PlayBoard_STM_Cube/Core/Src/main.c:
Copyright (c) 2024 STMicroelectronics.
All rights reserved.
This software is licensed under terms that can be found in the LICENSE file
